dejan345/kicad-gruvbox/Door Latch Clip Plastic.3mf

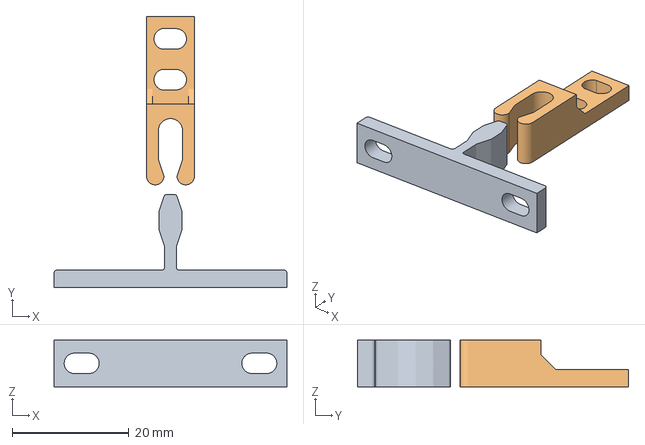
[picture p1: CAD file, 2025-08-06]
Door Latch Clip Plastic.3mf
40.0 x 46.6 x 8.00 mm
Door Latch Clip Plastic.stl_1
Door Latch Clip Plastic.stl_2
