dejan345/kicad-gruvbox/Door Latch Clip Plastic -2.3mf

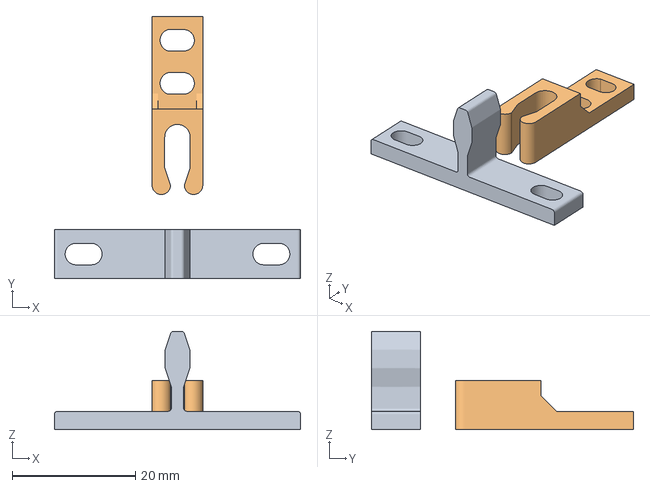
[picture p2: CAD file, 2025-08-06]
Door Latch Clip Plastic -2.3mf
40.0 x 42.6 x 16.0 mm
Door Latch Clip Plastic.stl_1
Door Latch Clip Plastic.stl_2
