dejan345/kicad-gruvbox/(list of files, cad)

Other CAD files:
Door Latch Clip Plastic.stl
