dejan345/kicad-gruvbox/(commit log)

2025-07-25 Add kicad part
2025-07-28 Add corne cherry
    [corne-cherry.kicad_pcb, corne-cherry.kicad_sch]
2025-08-06 Add Door latch
    [Door Latch Clip Plastic -2.3mf, Door Latch Clip Plastic.3mf, Door Latch Clip Plastic.stl]
